JakeHafele101/HAL/README.md

# HAL
Hal is used to take in inputs from CAN and send them to our compute module. It has one 2 pin connector to take in all these inputs, which are the core of the board. HAL is powered off 12V_Main.
