JakeHafele101/HAL/BOM/HAL_REV6_BOM.xlsx

General Part | PCB Label | Custom Reference | Manufacturer Number | Retailer Number | Package Size | Value | Retailer Link | Amount Per Board | Cost per unit | Amount Per Order | Cost Per Order Per Part | Board Name: | HAL
2 pin megafit | J1 | HAL J1 | 768250002 | WM11969-ND | 2 pin mega |  | https://www.digikey.com/en/products/detail/molex/0768250002/5639611?s=N4IgTCBcDaIOwDYAcYCsAGTEC6BfIA | 2 | $1.31 | 6 | $7.86 | Number of Boards: | 3
Pfet 40V 10.8 A | Q1, Q3, Q4, Q5, Q9, Q10 | HAL Q1, Q3, Q4, Q5, Q9, Q10 | FDD4141 | FDD4141CT-ND | TO-252-3 |  | https://www.digikey.com/en/products/detail/onsemi/FDD4141/1658354 | 6 | $1.15 | 18 | $20.70 | Total cost: | $217.35
TVS Diode 20.1 V | D2, D3, D4, D5, D6, D7, D8, D9, D10, D11, D12, D13, D14 | HAL D2, D3, D4, D5, D6, D7, D8, D9, D10, D11, D12, D13, D14 | VTVS12ASMF-M3-08 | 112-VTVS12ASMF-M3-08CT-ND | DO-219AB |  | https://www.digikey.com/product-detail/en/vishay-semiconductor-diodes-division/VTVS12ASMF-M3-08/112-VTVS12ASMF-M3-08CT-ND/7055981 | 15 | $0.42 | 45 | $18.90
Ferrite Bead | FB1 | HAL FB1 | HI1206N800R-10 | 240-2409-1-ND | 1206 |  | https://www.digikey.com/en/products/detail/laird-signal-integrity-products/HI1206N800R-10/806646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 | 2 | $0.23 | 6 | $1.38
10uF 16V Capacitor | C2 | HAL C2 | CL31A106KOHNNNE | 1276-1137-1-ND | 1206 | 10uF 16V | https://www.digikey.com/en/products/detail/samsung-electro-mechanics/CL31A106KOHNNNE/3886795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 | 2 | $0.22 | 6 | $1.32
1uF 16V Capacitor | C1 | HAL C1 | CL31F105ZOCNNNC | 1276-2857-1-ND | 1206 | 1uF 16V | https://www.digikey.com/en/products/detail/samsung-electro-mechanics/CL31F105ZOCNNNC/3888515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 | 2 | $0.22 | 6 | $1.32
0.1 uF 100V Capacitor | C3 | HAL C3 | 08051C104M4Z2A | 478-7432-1-ND | 805 | 0.1 uF 100V | https://www.digikey.com/en/products/detail/kyocera-avx/08051C104M4Z2A/3660845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 | 2 | $0.20 | 6 | $1.20
4700 pF 50V Capacitor | C4 | HAL C4 | 06035C472K4T4A | 478-12727-1-ND | 603 | 4700 pF 50V | https://www.digikey.com/en/products/detail/kyocera-avx/06035C472K4T4A/1600193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 | 2 | $0.11 | 6 | $0.66
Mini Blade Fuse Holder | F1, F2, F3, F4, F5, F6, F7, F8, F9, F10, F11, F12, F13 | HAL F1, F2, F3, F4, F5, F6, F7, F8, F9, F10, F11, F12, F13 | 3568 | 36-3568-ND | Mini |  | https://www.digikey.com/en/products/detail/keystone-electronics/3568/2137306 | 15 | $1.22 | 45 | $54.90
Pfet 20V 3.7A | Q2 | HAL Q2 | IRLML6402TRPBF | IRLML6402PBFCT-ND | SOT-23-3 |  | https://www.digikey.com/en/products/detail/infineon-technologies/IRLML6402TRPBF/811437 | 2 | $0.48 | 6 | $2.88
1kOhm 0.25W Resistor | R1, R8, R9, R10, R11, R12, R13,R19, R20, R21, R22, R29, R30, R35, R27, R28, R34 | HAL R1, R8, R9, R10, R11, R12, R13,R19, R20, R21, R22, R29, R30, R35, R27, R28, R34 | RK73B2BTTD102J | 2019-RK73B2BTTD102JCT-ND | 1206 | 1kOhm 0.25W | https://www.digikey.com/en/products/detail/koa-speer-electronics-inc/RK73B2BTTD102J/10248345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 | 20 | $0.10 | 60 | $6.00
LED Red Diffused Chip | Fault1 | HAL Fault1 | HSMH-C150 | 516-1439-1-ND | 1206 |  | https://www.digikey.com/en/products/detail/broadcom-limited/HSMH-C150/637700 | 2 | $0.80 | 6 | $4.80
5V Switching Reg | U1 | HAL U1 | R-78AA5.0-1.0SMD-R | 945-1044-1-ND | 10-SMD |  | https://www.digikey.com/en/products/detail/recom-power/R-78AA5-0-1-0SMD-R/2256224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 | 0 | $9.84 | 0 | $0.00
Diode 50V | D1 | HAL D1 | 1N4001-T | 2516-1N4001-TTR-ND | DO-41 |  | https://www.digikey.com/en/products/detail/rectron-usa/1N4001-T/12440240 | 3 | 0 | 9 | $0.00
2 pin minifit | CAN 1, CAN 2 | HAL CAN 1, CAN 2 | 39300020 | WM21351-ND | 2 pin mini |  | https://www.digikey.com/en/products/detail/molex/0039300020/930320?s=N4IgTCBcDaIOoFkwEYDMBWZBaAcgERAF0BfIA | 5 | $0.77 | 15 | $11.55
10 pF 50V Capacitor | C5, C66 | HAL C5, C66 | CL21C100CBANNNC | 1276-2561-2-ND | 805 | 10pF 50V | https://www.digikey.com/en/products/detail/samsung-electro-mechanics/CL21C100CBANNNC/3888219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 | 5 | $0.10 | 15 | $1.50
6 pin megafit | J2, J3, J4, J5 | HAL J2, J3, J4, J5 | 768250006 | WM11971-ND | 6 pin mega |  | https://www.digikey.com/en/products/detail/molex/0768250006/5639613?s=N4IgTCBcDaIOoFkCMSCcB2JBaAcgERAF0BfIA | 5 | $2.80 | 15 | $42.00
Nfet 20V 3.2A | Q6, Q7, Q8, Q11, Q12 | HAL Q6, Q7, Q8, Q11, Q12 | NTR4501NT1G | NTR4501NT1GOSCT-ND | SOT-23-3 |  | https://www.digikey.com/en/products/detail/onsemi/NTR4501NT1G/687097 | 10 | $0.40 | 30 | $12.00
10kOhm 1/8W Resistor | R5, R6, R7, R8, R14, R15, R16, R17, R18, R23, R24, R25, R26, R31, R32, R33, R36 | HAL R5, R6, R7, R8, R14, R15, R16, R17, R18, R23, R24, R25, R26, R31, R32, R33, R36 | RC0805FR-0710KL | 311-10.0KCRCT-ND | 805 | 10k | https://www.digikey.com/en/products/detail/yageo/RC0805FR-0710KL/727535 | 30 | $0.10 | 90 | $9.00
1MOhm 0.1W Resistor | R37, R38, R39, R40, R41, R42, R43, R44 | HAL R37, R38, R39, R40, R41, R42, R43, R44 | CRCW06031M00FKEA | 541-1.00MHCT-ND | 603 | 1MOhm 0.1W | https://www.digikey.com/en/products/detail/vishay-dale/CRCW06031M00FKEA/1175010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 | 10 | $0.10 | 30 | $3.00
Slide Switch | S1 | HAL S1 | CAS-D20TB | CASD20GCT-ND | SPDT x 2 |  | https://www.digikey.com/en/products/detail/nidec-copal-electronics/CAS-D20TB/341666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 | 3 | $1.82 | 9 | $16.38
