JakeHafele101/HAL/Altium Project/HAL.pdf

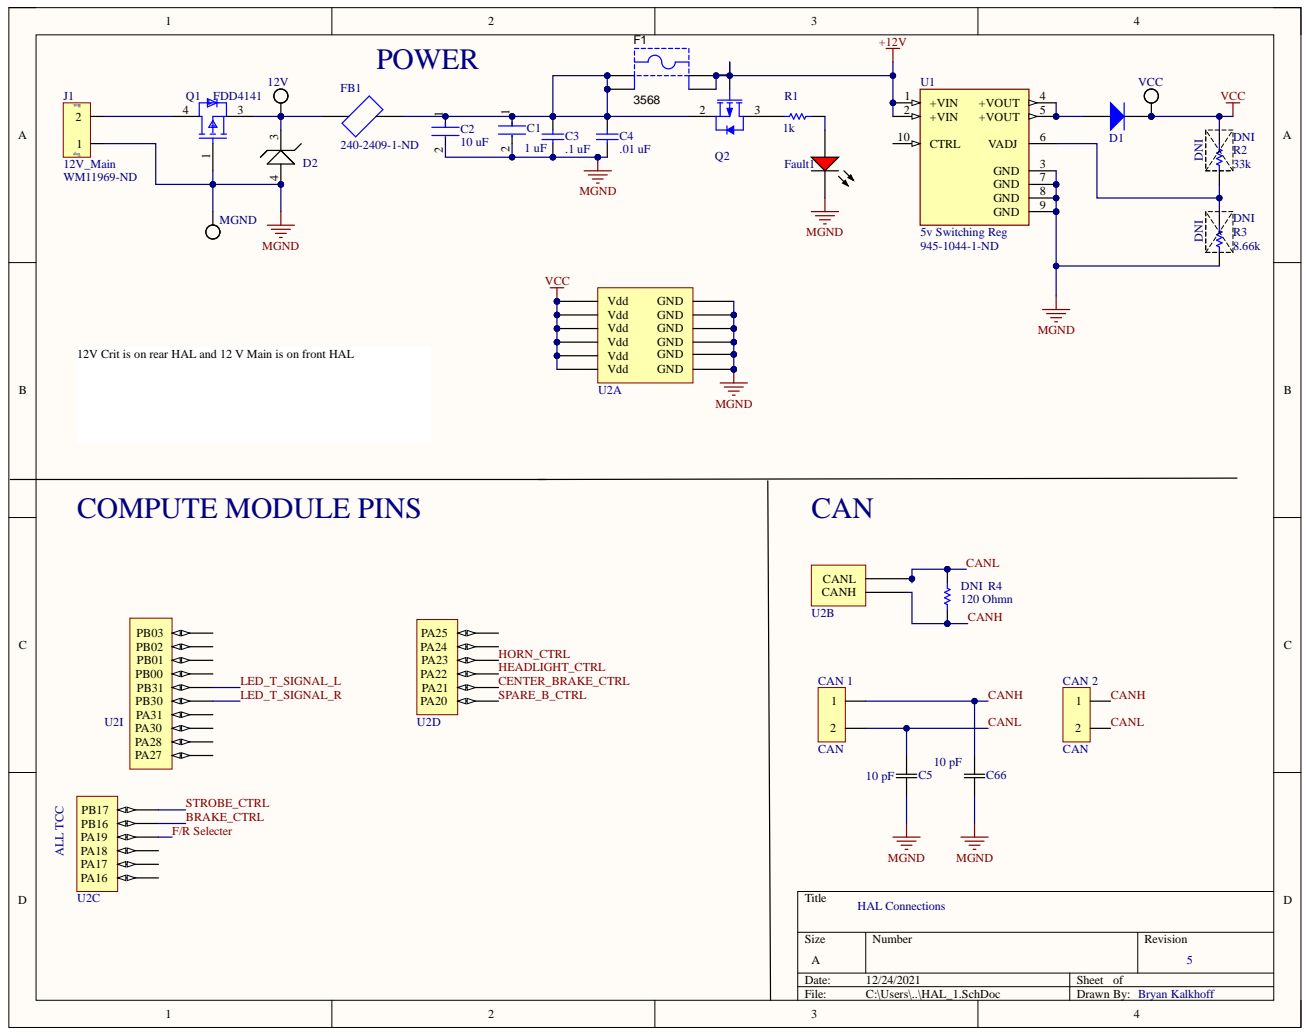
[picture p31: page 1]

12V Crit is on rear HAL and 12 V Main is on front HAL

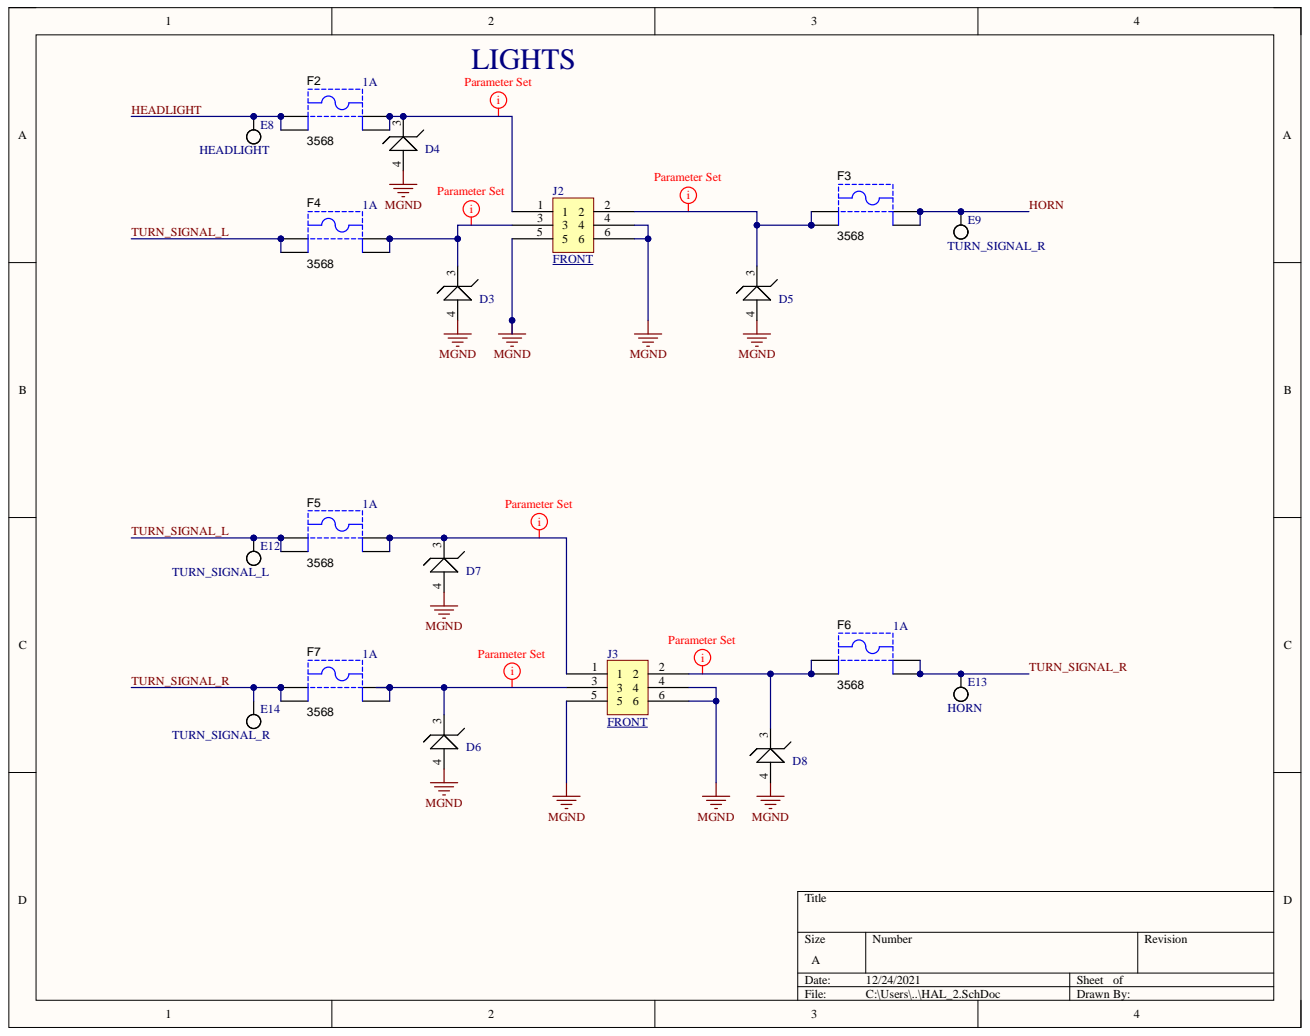
[picture p32: page 2]

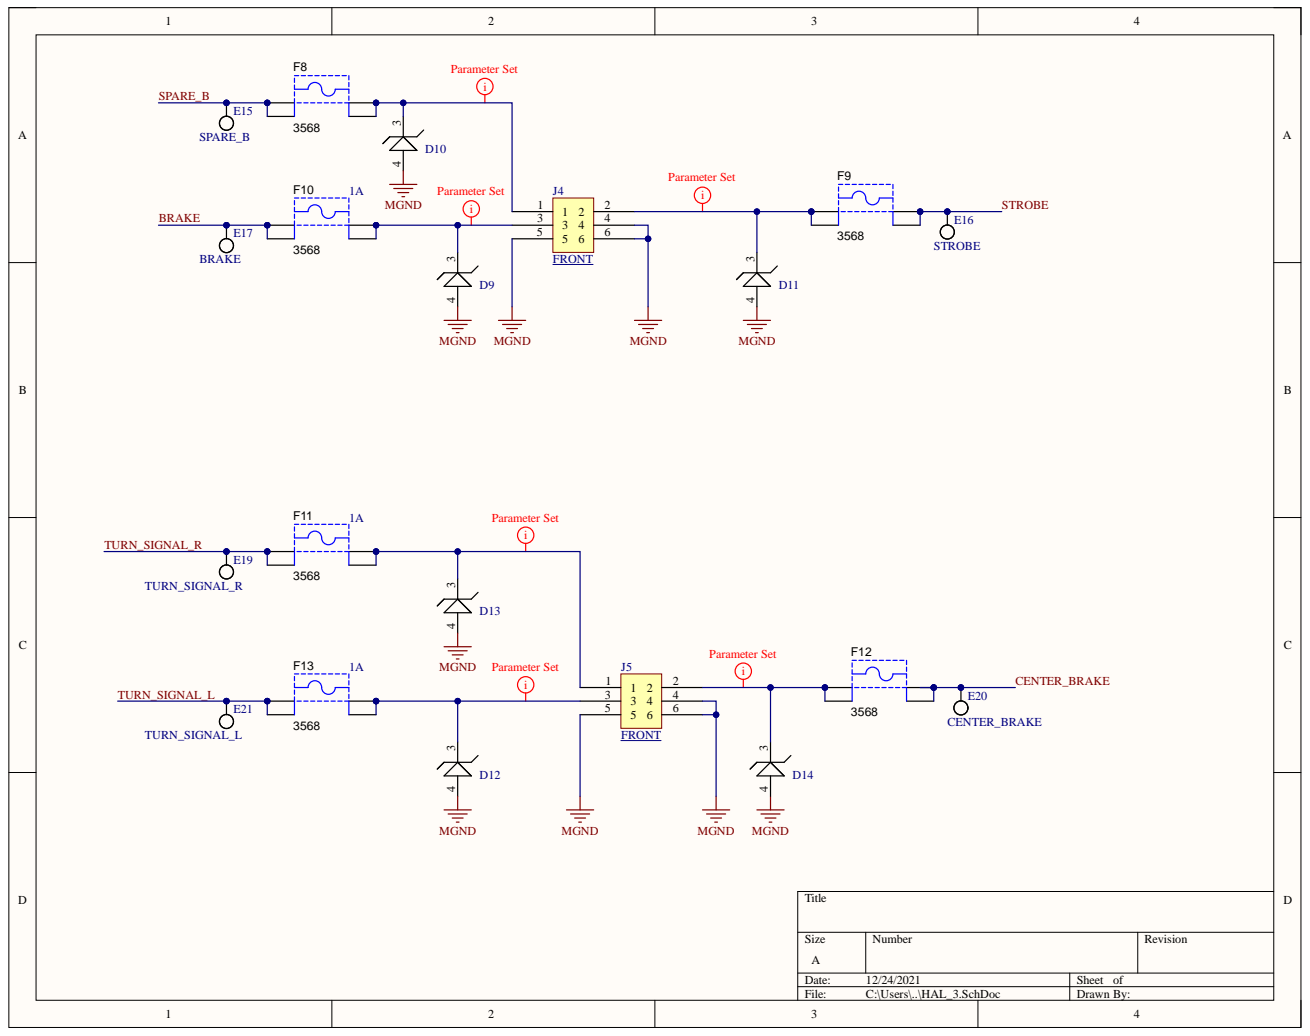
[picture p33: page 3]

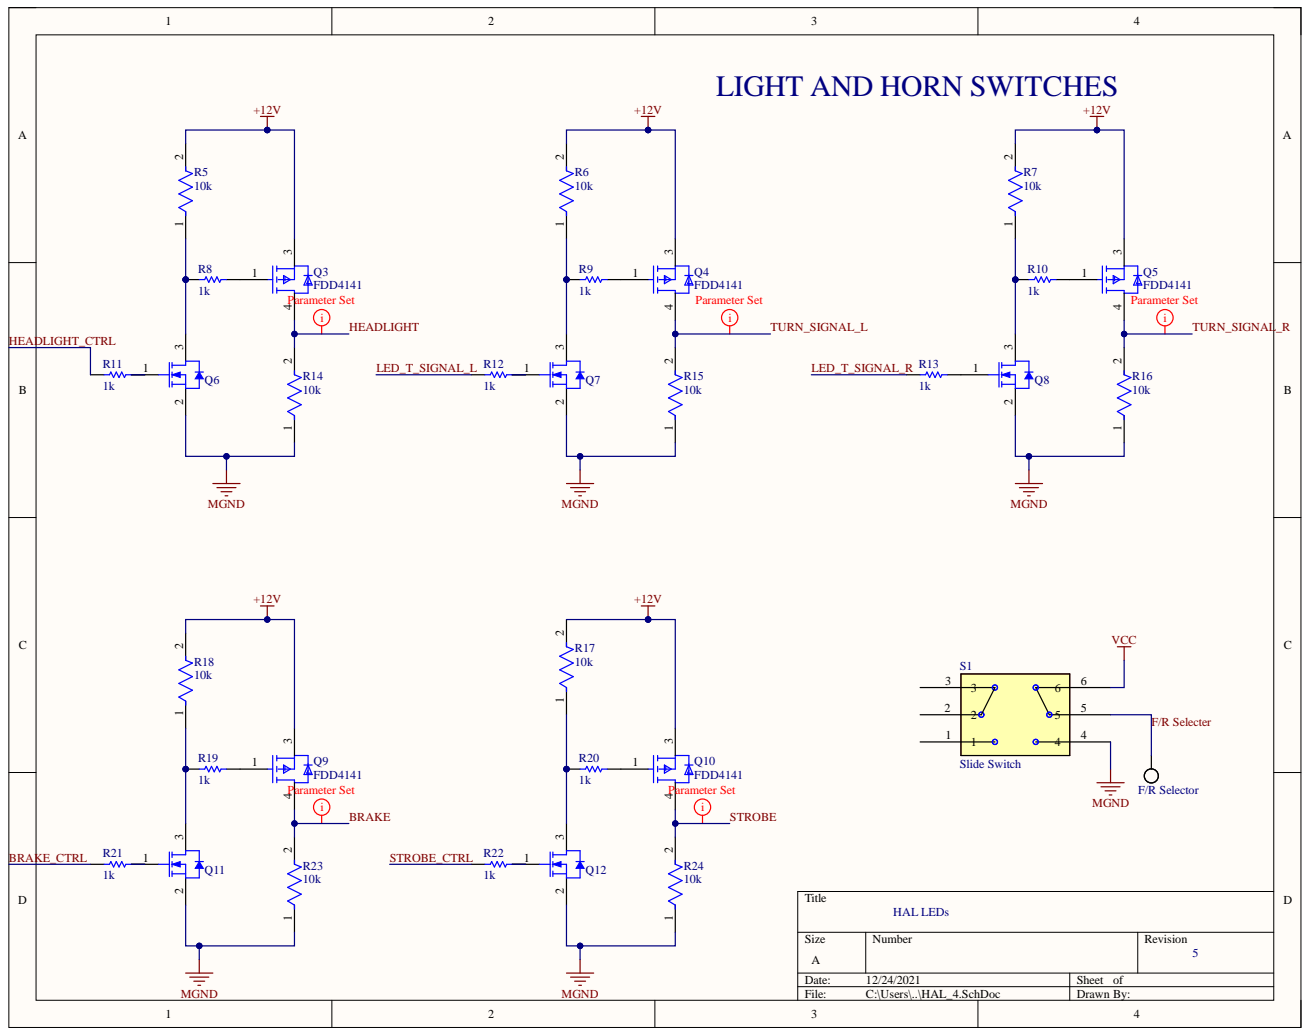
[picture p34: page 4]

LIGHT AND HORN SWITCHES

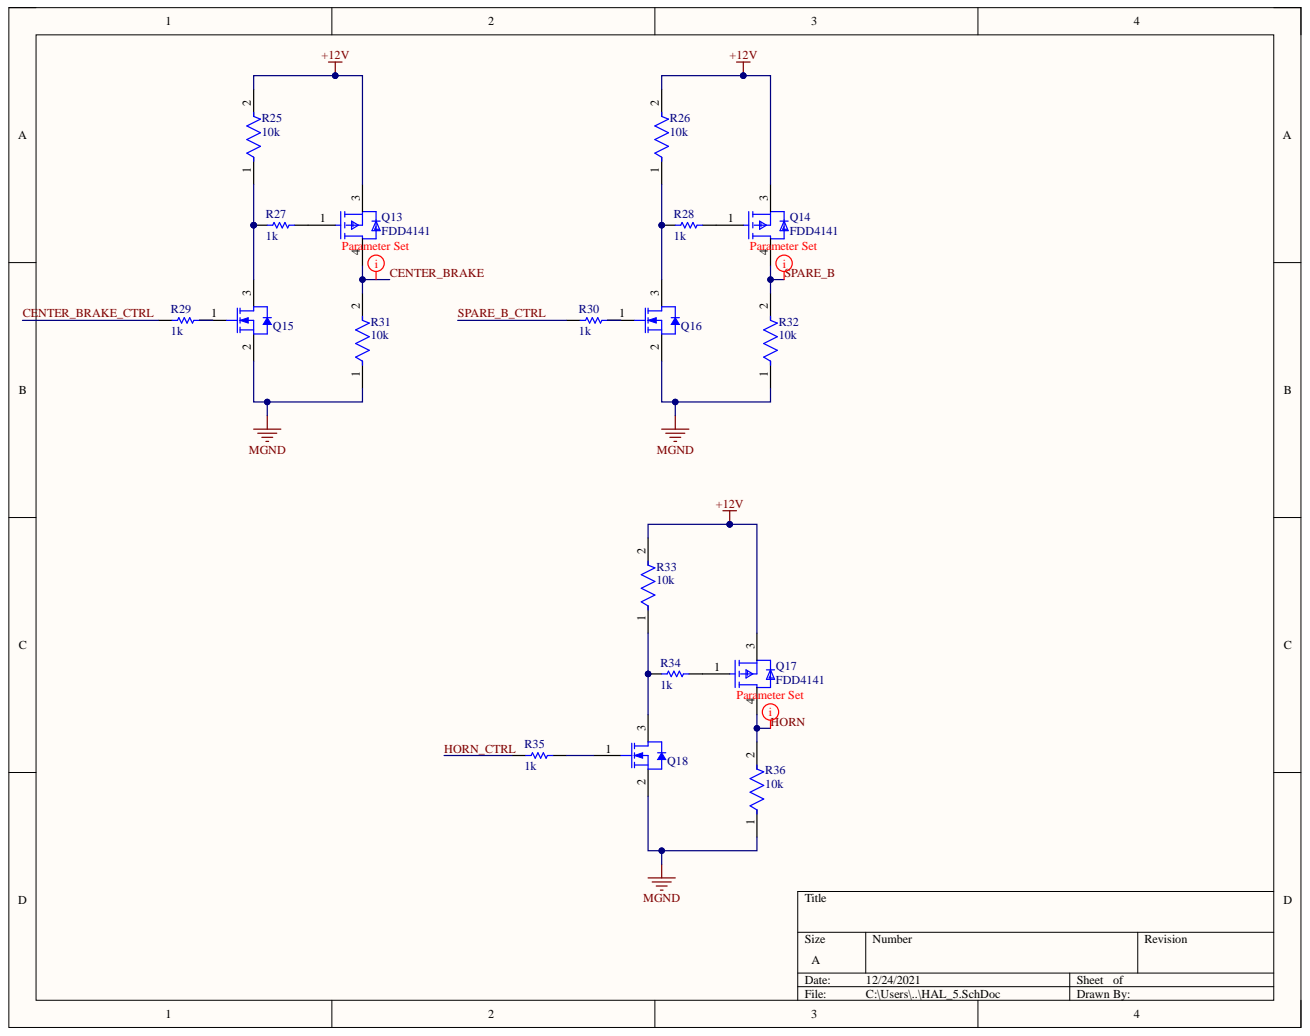
[picture p35: page 5]

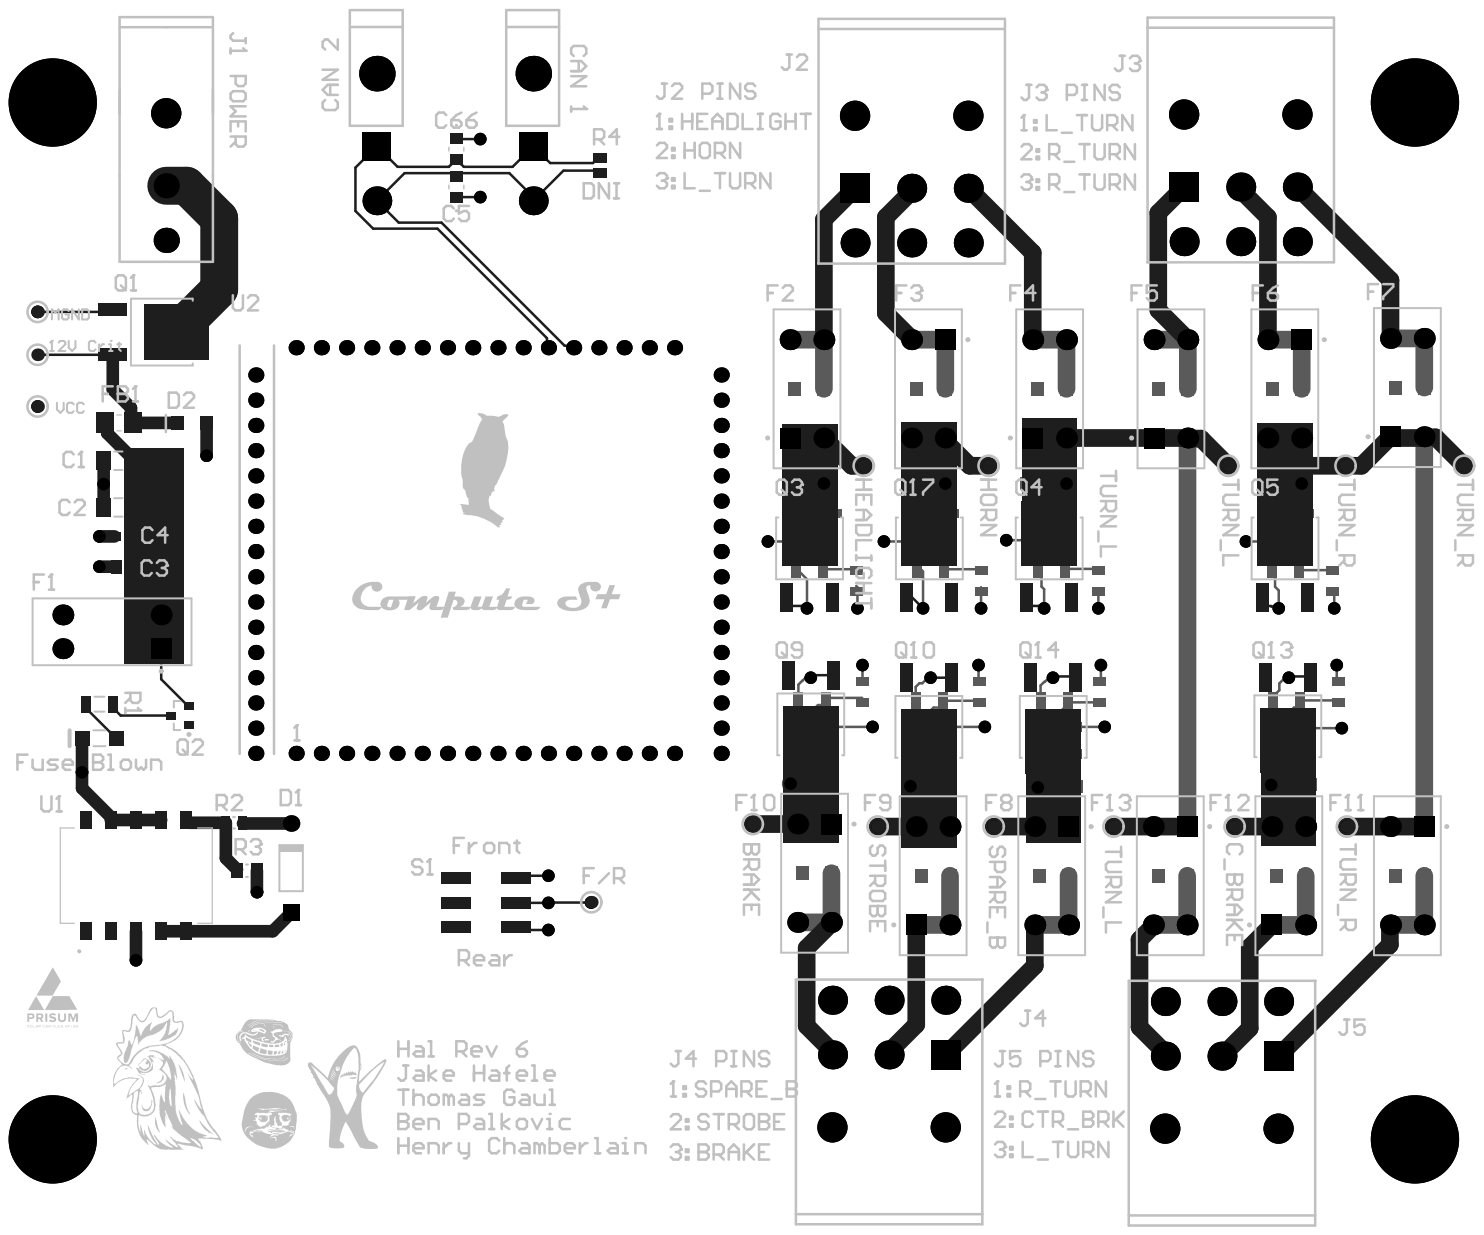
[picture p36: page 6]
