JakeHafele101/HAL/Documentation/HAL.pdf

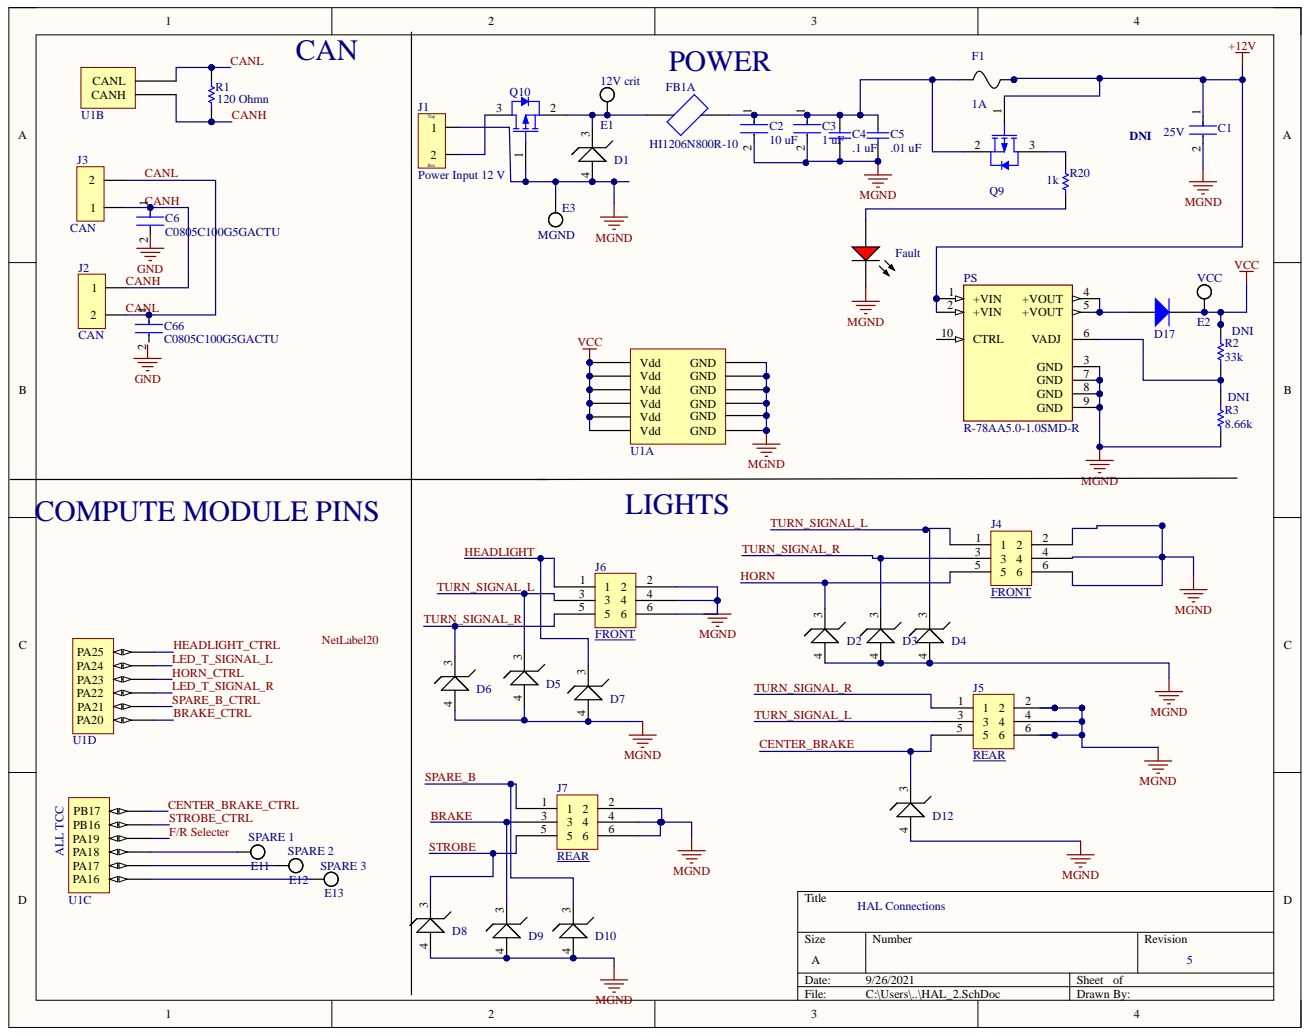
[picture p37: page 1]

TURN_SIGNAL_R

FRONT NetLabel20

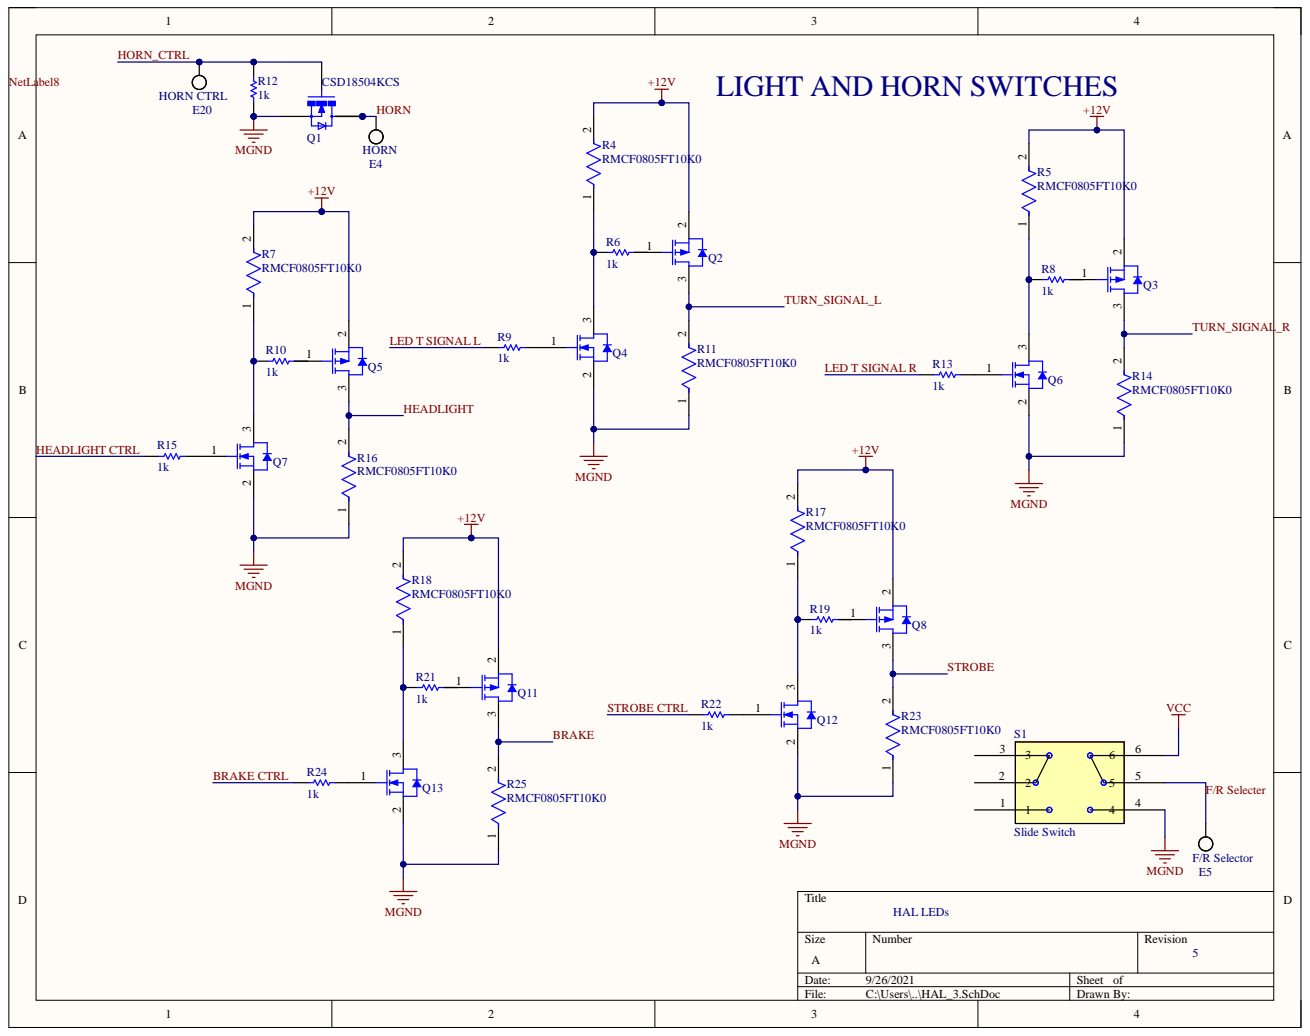
[picture p38: page 2]

LIGHT AND HORN SWITCHES

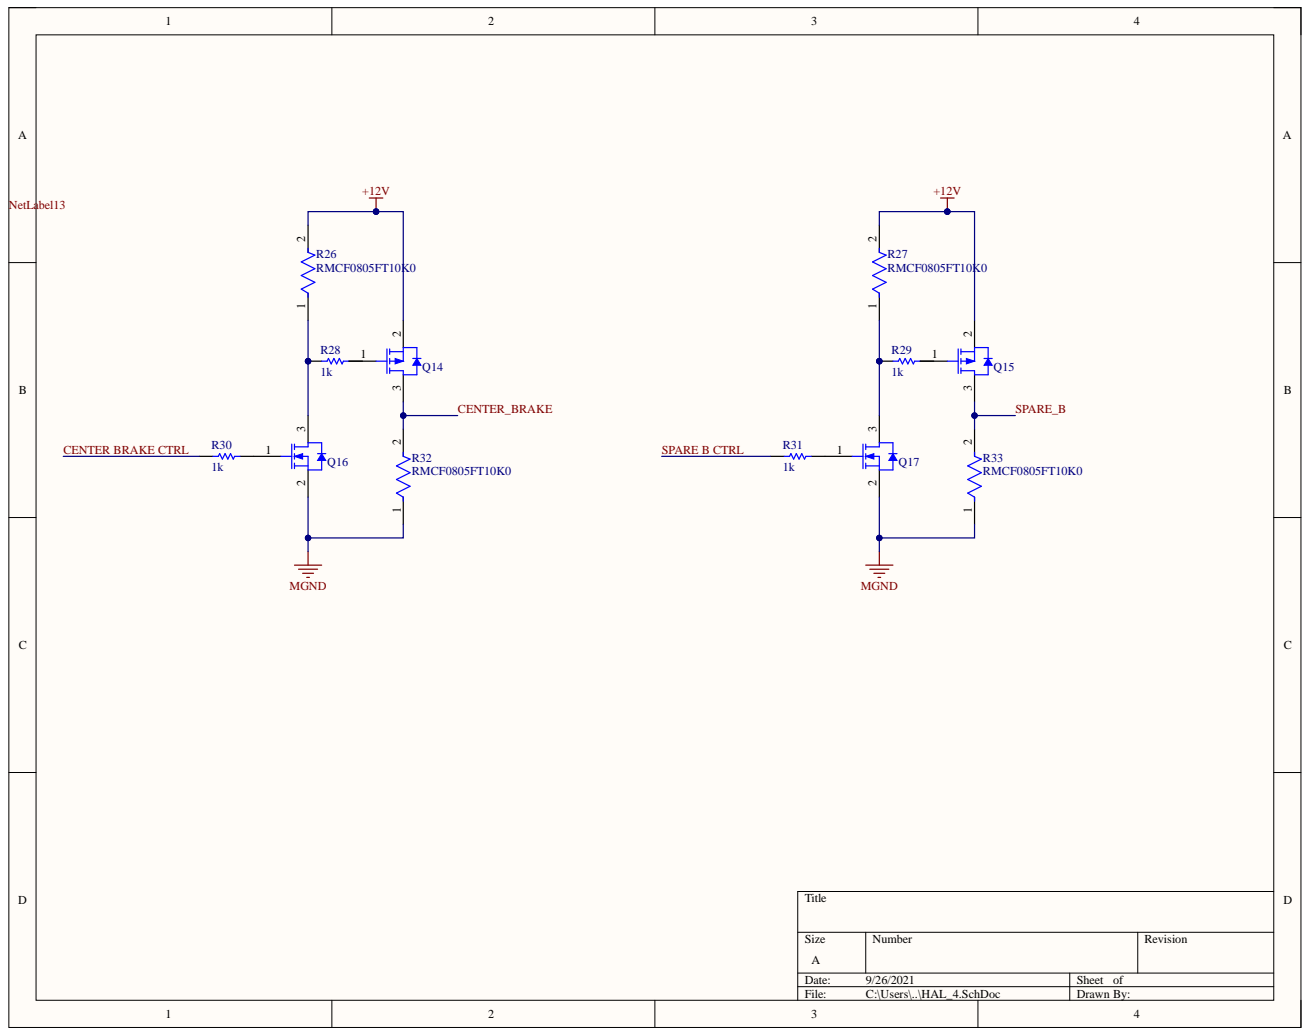
[picture p39: page 3]

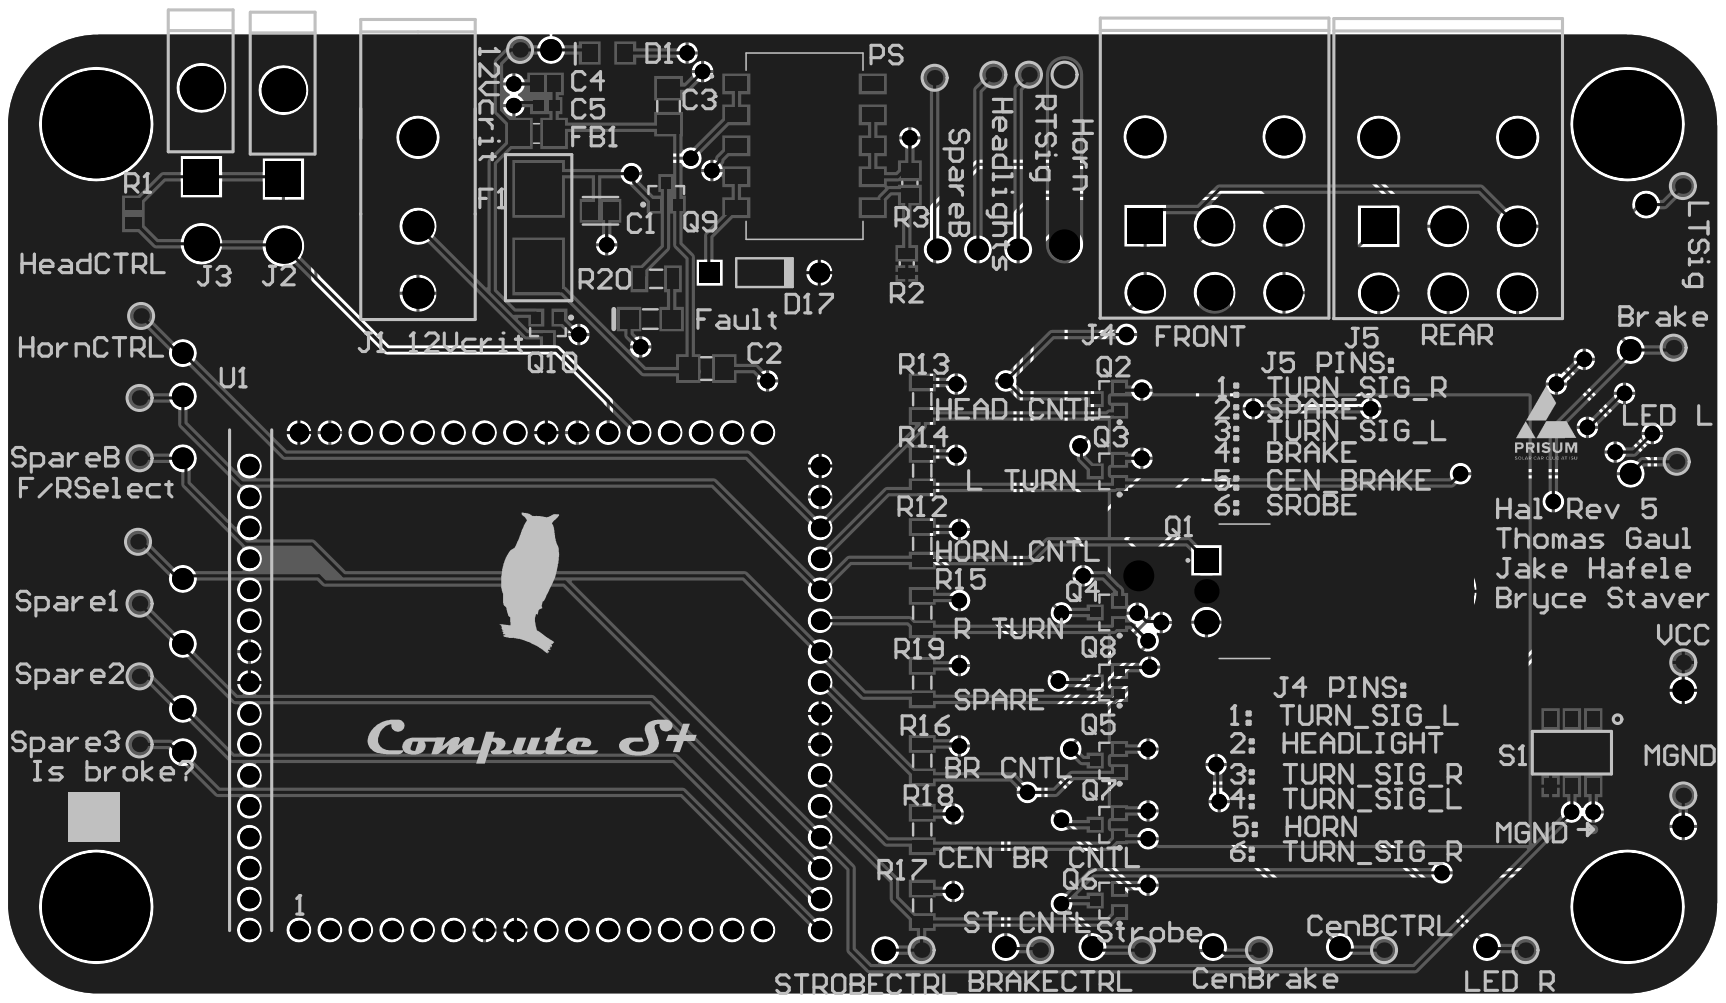
[picture p40: page 4]
