JakeHafele101/HAL/(list of files, drawings)

Other design files:
Altium Project/Compute.SchLib
Altium Project/Compute_module.PcbLib
Altium Project/HAL1/HAL.SCHLIB
Altium Project/HAL1/HAL_2.PcbLib
Altium Project/HAL and MotorBoard.PcbLib
Altium Project/HAL and MotorBoard.SchLib
Altium Project/HAL.PrjPcb
Altium Project/HAL_1.SchDoc
Altium Project/HAL_2.PcbDoc
Altium Project/HAL_2.SchDoc
Altium Project/HAL_3.SchDoc
Altium Project/HAL_4.SchDoc
Altium Project/HAL_5.SchDoc
